muccc/flipdots/libsimplespi/README

1) run spi-setup as root
2) make install
3) reboot
4) PROFIT
