muccc/flipdots/board/FlipdotMini.brd

## EAGLE design board/FlipdotMini.brd (2017-11-04)

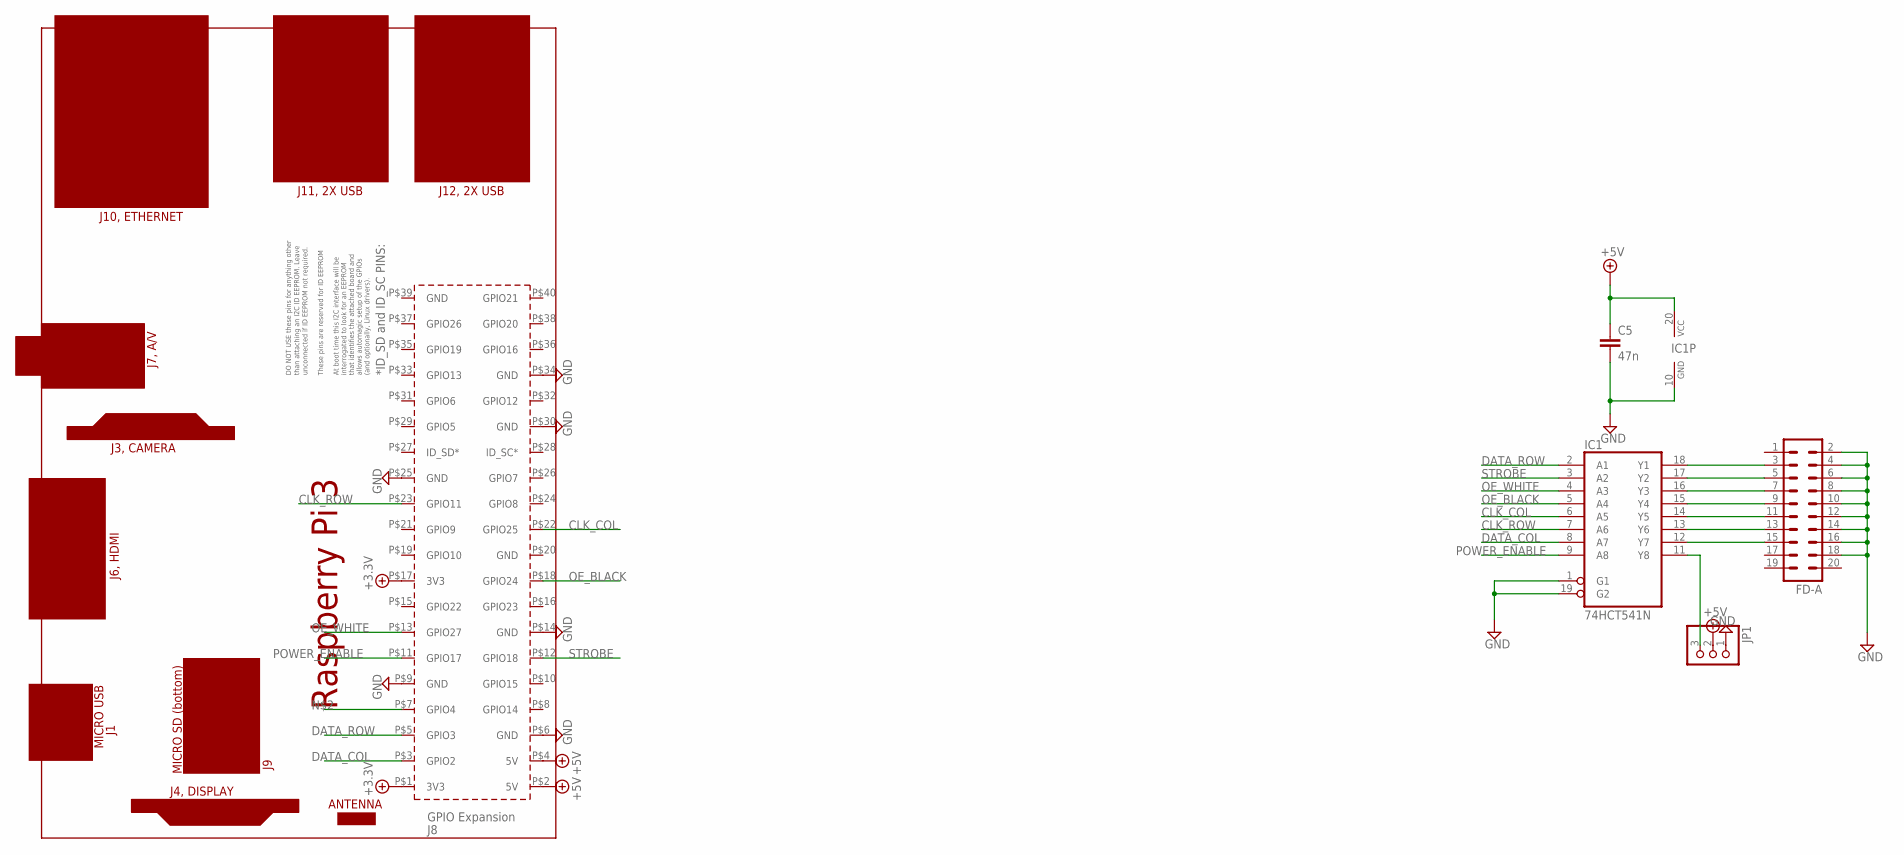
[picture p1: schematic FlipdotMini.sch]

Parts:
C5: 47n; C0805
FD-A: MA10-2
IC1: 74HCT541N; DIL20
JP1: PINHD-1X3; 1X03
PCB1: RPI3

Connections:
+3.3V: PCB1.P$1 (3V3), PCB1.P$17 (3V3)
+5V: C5.1, IC1.20 (VCC), JP1.2, PCB1.P$2 (5V), PCB1.P$4 (5V)
CLK_COL: IC1.6 (A5), PCB1.P$22 (GPIO25)
CLK_ROW: IC1.7 (A6), PCB1.P$23 (GPIO11)
DATA_COL: IC1.8 (A7), PCB1.P$3 (GPIO2)
DATA_ROW: IC1.2 (A1), PCB1.P$5 (GPIO3)
GND: C5.2, FD-A.2, FD-A.4, FD-A.6, FD-A.8, FD-A.10, FD-A.12, FD-A.14, FD-A.16, FD-A.18, IC1.1 (G1), IC1.10 (GND), IC1.19 (G2), JP1.1, PCB1.P$6 (GND), PCB1.P$9 (GND), PCB1.P$14 (GND), PCB1.P$25 (GND), PCB1.P$30 (GND), PCB1.P$34 (GND)
unnamed: FD-A.3, IC1.18 (Y1)
unnamed: FD-A.5, IC1.17 (Y2)
unnamed: FD-A.7, IC1.16 (Y3)
unnamed: FD-A.9, IC1.15 (Y4)
unnamed: FD-A.11, IC1.14 (Y5)
unnamed: FD-A.13, IC1.13 (Y6)
unnamed: FD-A.15, IC1.12 (Y7)
unnamed: IC1.11 (Y8), JP1.3
OE_BLACK: IC1.5 (A4), PCB1.P$18 (GPIO24)
OE_WHITE: IC1.4 (A3), PCB1.P$13 (GPIO27)
POWER_ENABLE: IC1.9 (A8), PCB1.P$11 (GPIO17)
STROBE: IC1.3 (A2), PCB1.P$12 (GPIO18)

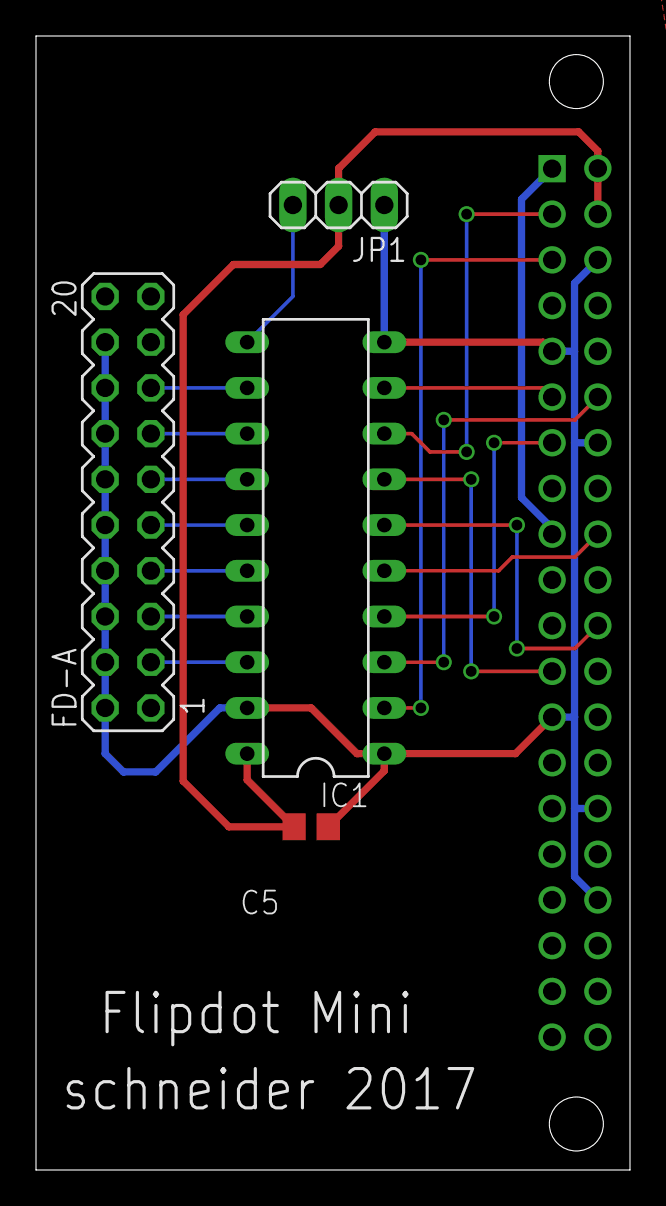
[picture p2: board FlipdotMini.brd from above]

Board: 2 copper layers, 33.0 x 63.0 mm, 5 parts (0 on the bottom side), 19 nets.
