muccc/flipdots/board/Flipdot.brd

## EAGLE design board/Flipdot.brd (2017-03-02)

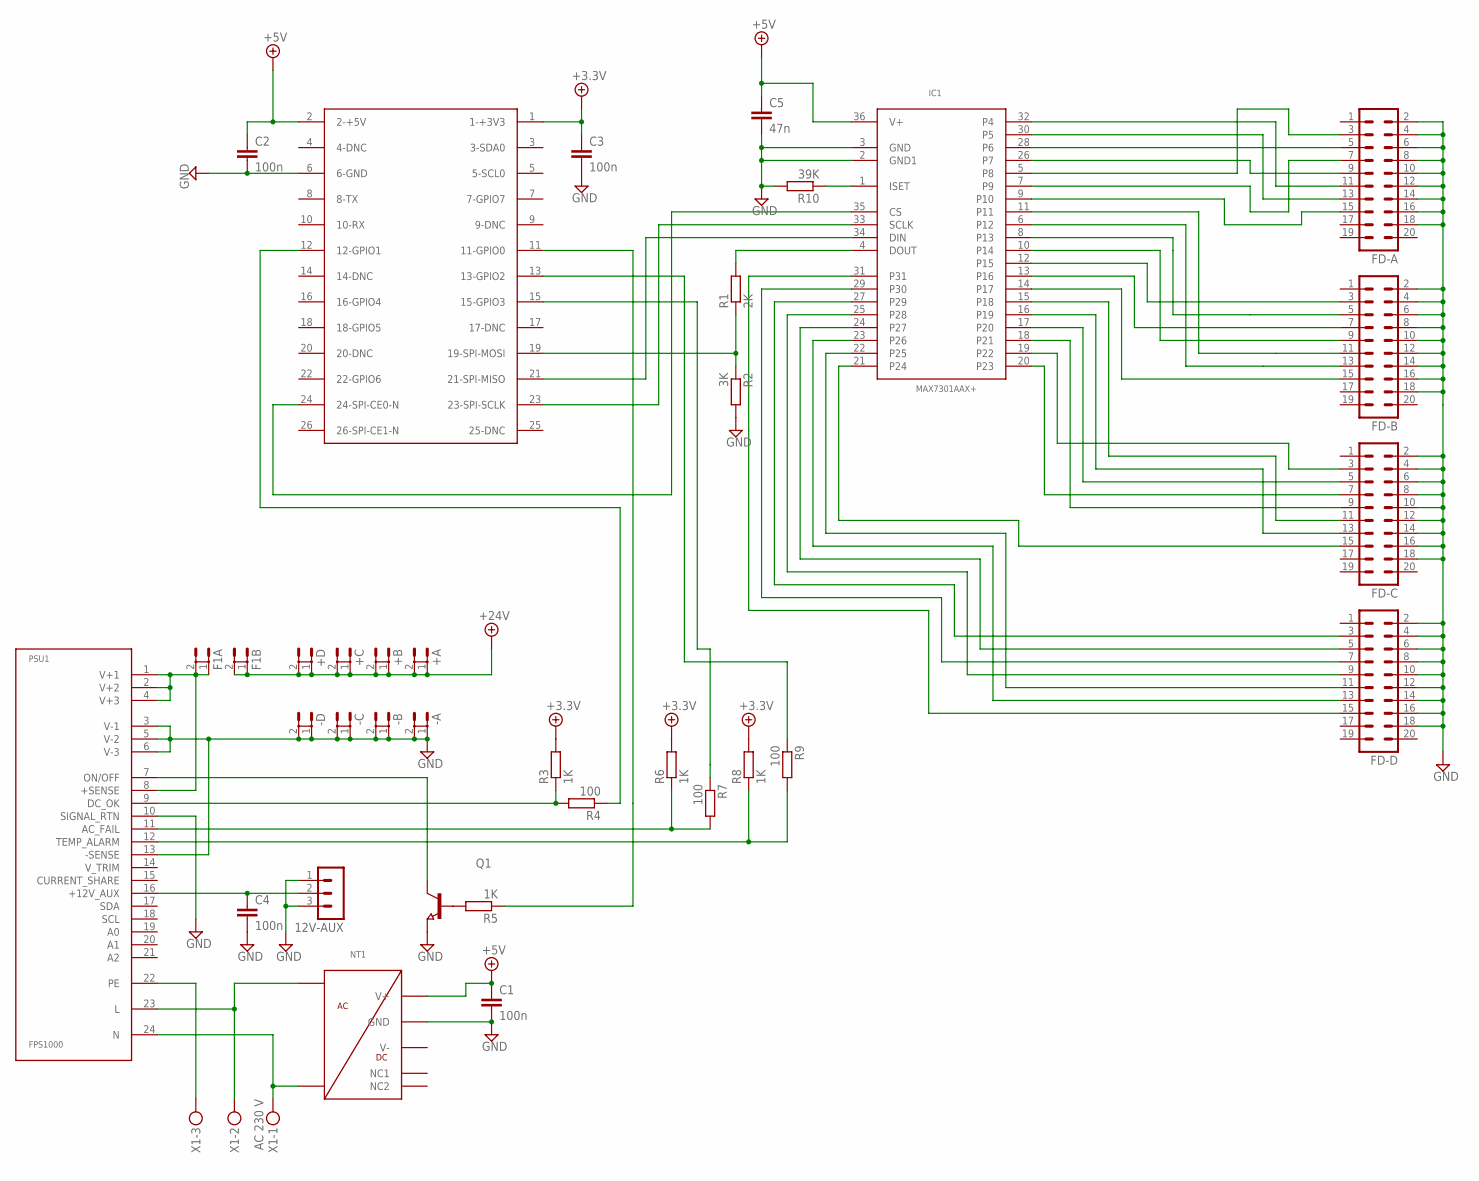
[picture p3: schematic Flipdot.sch]

Parts:
12V-AUX: MA03-1
+A: ST6,3
+B: ST6,3
+C: ST6,3
+D: ST6,3
-A: ST6,3
-B: ST6,3
-C: ST6,3
-D: ST6,3
C1, C2, C3, C4: 100n; C0603
C5: 47n; C0603
F1A, F1B: ST6,3
FD-A: MA10-2
FD-B: MA10-2
FD-C: MA10-2
FD-D: MA10-2
IC1: MAX7301AAX+; SSOP36
NT1: TMPM04; TPM04
PSU1: FPS1000; 24W9F
Q1: NPN-TRANSISTOR_SOT23; SOT23
R1: 2K; R0603
R2: 3K; R0603
R3, R5, R6, R8: 1K; R0603
R4, R7, R9: 100; R0603
R10: 39K; R0603
U$1: RASPBERRY-PI
X1: AC 230 V; MKDSN1,5/3-5,08

Connections:
+3.3V: C3.1, R3.2, R6.2, R8.2, U$1.1 (1-+3V3)
+5V: C1.1, C2.1, C5.1, IC1.36 (V+), NT1.3 (V+), U$1.2 (2-+5V)
+24V: +A.1, +A.2, +B.1, +B.2, +C.1, +C.2, +D.1, +D.2, F1B.1, F1B.2
GND: 12V-AUX.1, 12V-AUX.3, -A.1, -A.2, -B.1, -B.2, -C.1, -C.2, -D.1, -D.2, C1.2, C2.2, C3.2, C4.2, C5.2, FD-A.2, FD-A.4, FD-A.6, FD-A.8, FD-A.10, FD-A.12, FD-A.14, FD-A.16, FD-A.18, FD-B.2, FD-B.4, FD-B.6, FD-B.8, FD-B.10, FD-B.12, FD-B.14, FD-B.16, FD-B.18, FD-C.2, FD-C.4, FD-C.6, FD-C.8, FD-C.10, FD-C.12, FD-C.14, FD-C.16, FD-C.18, FD-D.2, FD-D.4, FD-D.6, FD-D.8, FD-D.10, FD-D.12, FD-D.14, FD-D.16, FD-D.18, IC1.2 (GND1), IC1.3 (GND), NT1.4 (GND), PSU1.3 (V-1), PSU1.5 (V-2), PSU1.6 (V-3), PSU1.10 (SIGNAL_RTN), PSU1.13 (-SENSE), Q1.2 (E), R2.2, R10.2, U$1.6 (6-GND)
unnamed: FD-D.11, IC1.22 (P25)
unnamed: FD-D.13, IC1.23 (P26)
unnamed: FD-A.5, IC1.28 (P6)
unnamed: FD-A.9, IC1.26 (P7)
unnamed: FD-A.3, IC1.5 (P8)
unnamed: FD-A.7, IC1.7 (P9)
unnamed: FD-A.15, IC1.9 (P10)
unnamed: FD-B.5, IC1.8 (P13)
unnamed: FD-B.9, IC1.10 (P14)
unnamed: FD-B.3, IC1.12 (P15)
unnamed: FD-B.7, IC1.13 (P16)
unnamed: FD-B.15, IC1.14 (P17)
unnamed: FD-C.5, IC1.17 (P20)
unnamed: FD-C.9, IC1.18 (P21)
unnamed: FD-C.3, IC1.19 (P22)
unnamed: FD-C.7, IC1.20 (P23)
unnamed: FD-C.15, IC1.21 (P24)
unnamed: FD-D.5, IC1.24 (P27)
unnamed: FD-D.9, IC1.25 (P28)
unnamed: FD-D.3, IC1.27 (P29)
unnamed: FD-D.7, IC1.29 (P30)
unnamed: FD-D.15, IC1.31
unnamed: IC1.33 (SCLK), U$1.23 (23-SPI-SCLK)
unnamed: IC1.35 (CS), U$1.24 (24-SPI-CE0-N)
unnamed: IC1.34 (DIN), U$1.21 (21-SPI-MISO)
unnamed: F1A.1, F1A.2, PSU1.1 (V+1), PSU1.2 (V+2), PSU1.4 (V+3), PSU1.8 (+SENSE)
unnamed: Q1.1 (B), R5.2
unnamed: PSU1.7 (ON/OFF), Q1.3 (C)
unnamed: PSU1.9 (DC_OK), R3.1, R4.2
unnamed: R5.1, U$1.11 (11-GPIO0)
unnamed: R4.1, U$1.12 (12-GPIO1)
unnamed: PSU1.11 (AC_FAIL), R6.1, R7.2
unnamed: R9.1, U$1.13 (13-GPIO2)
unnamed: PSU1.12 (TEMP_ALARM), R8.1, R9.2
unnamed: R7.1, U$1.15 (15-GPIO3)
unnamed: PSU1.22 (PE), X1.3
unnamed: FD-B.13, IC1.6 (P12)
unnamed: IC1.4 (DOUT), R1.2
unnamed: R1.1, R2.1, U$1.19 (19-SPI-MOSI)
unnamed: FD-B.11, IC1.11
unnamed: FD-C.11, IC1.15 (P18)
unnamed: FD-A.11, IC1.32 (P4)
unnamed: FD-C.13, IC1.16 (P19)
unnamed: FD-A.13, IC1.30 (P5)
unnamed: NT1.6 (N), PSU1.24 (N), X1.1
unnamed: NT1.7 (L), PSU1.23 (L), X1.2
unnamed: IC1.1 (ISET), R10.1
unnamed: 12V-AUX.2, C4.1, PSU1.16 (+12V_AUX)
NC1: NT1.1 (NC1)
NC2: NT1.2 (NC2)
V-: NT1.5 (V-)

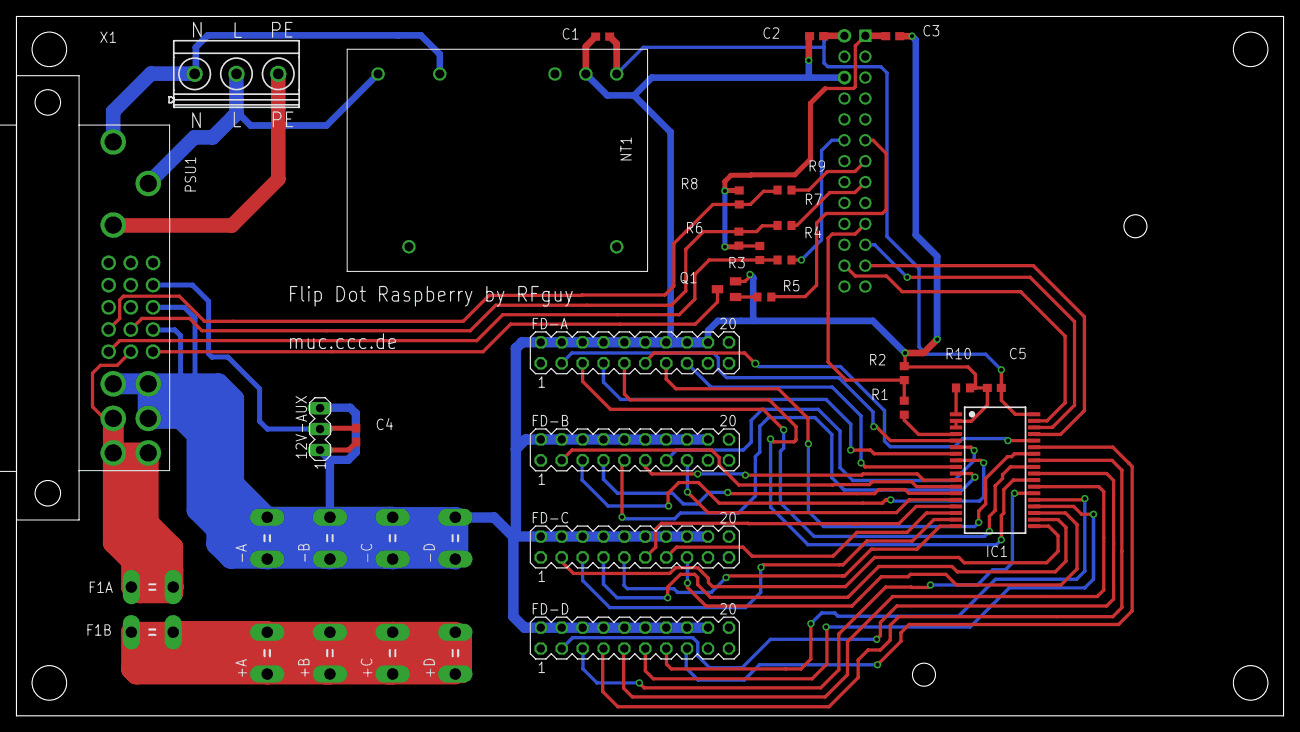
[picture p4: board Flipdot.brd from above]

Board: 2 copper layers, 154.0 x 85.0 mm, 36 parts (1 on the bottom side), 52 nets.
