muccc/flipdots/(threads)

Thread 7 (2013-09-22):

look for alternativ spi library or improve current one

schneider42, 2013-09-22:
the current one is slow and produces strange pulses on the /CS line.

Have a look a https://github.com/mstaflex/SPI-Py or quick to wire

dergigo, 2017-03-03:
@schneider42 are you still working on it?

schneider42, 2017-03-03:
We will replace the whole thing with direct GPIO access and remove the SPI port expander.

morawekj, 2017-03-03:
Neues PCB ?, ein Level Shifter wäre als Busentkopplung Sinnvoll

Closed 2017-03-03.

Thread 14 (2017-03-03):

Reimplement udp-receiver in C

dergigo, 2017-03-03:
The python file flipdots/rpi-demo/udp_receiver_and_translator.py runs on the zeile and the wand for the following reasons:
  * enable and disable 24V power as required
  * fix the strange orientation of the flipdots in the zeile.

Both should be features of the the udp-receiver.c

Thread 19 (2017-08-16):

Refactor python2 scripts for python3

markus2342, 2017-08-16:
There are a number of python2 scripts in the scripts directory which should be converted to python3.

Typical issues to be encountered will be the use of strings as arguments to socket.sendto. This behaviour has changed with python3. socket.sendto now accepts a byte type as argument.
Ideally these affected scripts would be modified to use the FlipdotAPI which takes care of sending data to the flipdot matrix.
