muccc/flipdots/rpi-demo/flipdot.c

/*
* Copyright (c) 2013 Franz Nord
*
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
* For more information on the GPL, please go to:
* http://www.gnu.org/copyleft/gpl.html
*/

#include "flipdot.h"
#include "config.h"

#include <bcm2835.h>
#include <time.h>
#include <stdlib.h>
#include <stdint.h>
#include <string.h>
#include <stdbool.h>
#include <unistd.h>
#include <inttypes.h>
#include <stdio.h>


#if INVERT_GPIO
#define OH LOW
#define OL HIGH
#else
#define OH HIGH
#define OL LOW
#endif

//extern int usleep (__useconds_t __useconds);
//#define _delay_us(x) usleep(x)
#define _delay_us(x) bcm2835_delayMicroseconds(x)


#define ISBITSET(x,i) ((x[i>>3] & (1<<(i&7)))!=0)
#define SETBIT(x,i) x[i>>3]|=(1<<(i&7));

#define DATA(reg)                                \
    ((reg == ROW) ? pinning.data_row : pinning.data_col)
#define CLK(reg)                                \
    ((reg == ROW) ? pinning.clk_row : pinning.clk_col)

static uint8_t buffer_a[DISP_BYTE_COUNT];
static uint8_t buffer_b[DISP_BYTE_COUNT];
static uint8_t buffer_to_0[DISP_BYTE_COUNT];
static uint8_t buffer_to_1[DISP_BYTE_COUNT];
static uint8_t *buffer_new, *buffer_old;

static void sreg_push_bit(enum sreg reg, uint8_t bit);
static void sreg_fill(enum sreg reg, uint8_t *data, int count);
static void sreg_fill_row(uint8_t *data, int count);
static void sreg_fill_col(uint8_t *data, int count);

static void strobe(void);
static void flip_white_start(void);
static void flip_white_stop(void);
static void flip_black_start(void);
static void flip_black_stop(void);

uint8_t diff_to_0(uint8_t old, uint8_t new);
uint8_t diff_to_1(uint8_t old, uint8_t new);

static void map_two_buffers(uint8_t (*fun)(uint8_t, uint8_t), uint8_t a[], uint8_t b[], uint8_t dst[], unsigned int count);

static void display_frame_differential(uint8_t *to_0, uint8_t *to_1);

#define PIN_POWER_ENABLE    RPI_V2_GPIO_P1_11
// XXX: Change to symbolic defines like RPI_V2_GPIO_P1_03
flipdot_pinning pinning =
{
    .data_col = RPI_V2_GPIO_P1_03, .data_row = RPI_V2_GPIO_P1_05, .strobe = RPI_V2_GPIO_P1_12, .oe_white = RPI_V2_GPIO_P1_13, .oe_black = RPI_V2_GPIO_P1_18, .clk_col = RPI_V2_GPIO_P1_22, .clk_row = RPI_V2_GPIO_P1_23
};

static uint8_t flipper[256];

static uint8_t reverse(uint8_t b)
{
    b = (b & 0xF0) >> 4 | (b & 0x0F) << 4;
    b = (b & 0xCC) >> 2 | (b & 0x33) << 2;
    b = (b & 0xAA) >> 1 | (b & 0x55) << 1;
    return b;
}

int
flipdot_init(void)
{
    //bcm2835_set_debug(1);
    if (!bcm2835_init())
        return 1;

    /* init pins */
    bcm2835_gpio_fsel(PIN_POWER_ENABLE, BCM2835_GPIO_FSEL_OUTP);

    bcm2835_gpio_fsel(pinning.data_col, BCM2835_GPIO_FSEL_OUTP);
    bcm2835_gpio_fsel(pinning.data_row, BCM2835_GPIO_FSEL_OUTP);
    bcm2835_gpio_fsel(pinning.strobe, BCM2835_GPIO_FSEL_OUTP);
    bcm2835_gpio_fsel(pinning.oe_white, BCM2835_GPIO_FSEL_OUTP);
    bcm2835_gpio_fsel(pinning.oe_black, BCM2835_GPIO_FSEL_OUTP);
    bcm2835_gpio_fsel(pinning.clk_col, BCM2835_GPIO_FSEL_OUTP);
    bcm2835_gpio_fsel(pinning.clk_row, BCM2835_GPIO_FSEL_OUTP);

    /* Init buffer pointers */
    buffer_new = buffer_a;
    buffer_old = buffer_b;

    /* Synchronize buffers and flipdot pixel state */
    memset(buffer_new, 0xFF, DISP_BYTE_COUNT);
    memset(buffer_old, 0x00, DISP_BYTE_COUNT);

    flipdot_power_on();
    flipdot_data(buffer_old, DISP_BYTE_COUNT);
    flipdot_data(buffer_old, DISP_BYTE_COUNT);
    flipdot_data(buffer_old, DISP_BYTE_COUNT);
    flipdot_power_off();

    int i;
    for(i=0; i<256; i++) {
        flipper[i] = reverse(i);
    }
    
    return 0;
}

void
flipdot_power_on(void)
{
    bcm2835_gpio_write(PIN_POWER_ENABLE, OH);
    while(bcm2835_gpio_lev(PIN_POWER_ENABLE) == OL){
        printf("Power set error\n");
        bcm2835_gpio_write(PIN_POWER_ENABLE, OH);
    }
}

void
flipdot_power_off(void)
{
    bcm2835_gpio_write(PIN_POWER_ENABLE, OL);
    while(bcm2835_gpio_lev(PIN_POWER_ENABLE) == OH){
        printf("Power clear error\n");
        bcm2835_gpio_write(PIN_POWER_ENABLE, OL);
    }
}

void
flipdot_data(uint8_t *frame, uint16_t size)
{
    uint8_t *tmp;

    memcpy(buffer_old, frame, size); /* Copy frame into buffer with old data */
    
    int i;
    for(i = 0; i < size; i++) {
        uint8_t c = buffer_old[i];
        buffer_old[i] = flipper[c];
    }

    tmp = buffer_old;                 /* swap pointers buffer_new and buffer_old */
    buffer_old = buffer_new;
    buffer_new = tmp;
    
    map_two_buffers(diff_to_0, buffer_old, buffer_new, buffer_to_0, DISP_BYTE_COUNT);
    map_two_buffers(diff_to_1, buffer_old, buffer_new, buffer_to_1, DISP_BYTE_COUNT);

    display_frame_differential(buffer_to_0, buffer_to_1);
}

static void
map_two_buffers(uint8_t (*fun)(uint8_t, uint8_t), uint8_t a[], uint8_t b[], uint8_t dst[], unsigned int count) {
    for (int i = 0; i < count; ++i) {
        dst[i] = fun(a[i], b[i]);
    }
}

uint8_t
diff_to_0(uint8_t old, uint8_t new) {
    return old & ~new;
}

uint8_t
diff_to_1(uint8_t old, uint8_t new) {
    return ~(~old & new);
}


static uint64_t timer;

static uint64_t
get_time(void)
{
    struct timespec time;
    clock_gettime(CLOCK_MONOTONIC_RAW, &time);
    uint64_t time_us = time.tv_sec * 1000000 + time.tv_nsec / 1000;
    return time_us;
}

static void
timer_start(void)
{
    timer = get_time();
}

static void
timer_wait(uint32_t micros)
{
    if(micros == 0) {
        return;
    }

    uint64_t elapsed = get_time() - timer;
    if(micros > elapsed) {
        _delay_us(micros - elapsed);
    } else {
        printf("Too slow: %" PRIu64 "/%" PRIu32 "\n", elapsed, micros);
    }
}

#if 1
// Load new row data while flipping
static void
display_frame_differential(uint8_t *to_0, uint8_t *to_1)
{
    uint8_t row_select[DISP_ROWS/8];
    int row;
    uint8_t *row_data_to_0, *row_data_to_1;

    // Select the first row
    row = 0;    
    memset(row_select, 0, DISP_ROWS/8);
    SETBIT(row_select, row);               /* Set selected row */
    sreg_fill(COL, row_select, DISP_ROWS); /* Fill row select shift register */

    // Pre-fill the data for row 0
    row_data_to_0 = to_0 + row * DISP_COLS/8;
    sreg_fill(ROW, row_data_to_0, DISP_COLS); /* Fill row to 0 shift register */

    while(row < DISP_ROWS) {
        // Apply the shift register content for the black pixels
        strobe();
        flip_black_start();

        row_data_to_1 = to_1 + row * DISP_COLS/8;
        sreg_fill(ROW, row_data_to_1, DISP_COLS); /* Fill row to 1 shift register */

        flip_black_stop();
        // Apply the shift register content for the white pixels
        strobe();
        flip_white_start();

        // Move one row further
        sreg_push_bit(COL, 0);
        row_data_to_0 = to_0 + (row+1) * DISP_COLS/8;
        sreg_fill(ROW, row_data_to_0, DISP_COLS); /* Fill row to 0 shift register */

        flip_white_stop();
        row++;
    }
}
#else
// Load new row data between flipping (slower)
static void
display_frame_differential(uint8_t *to_0, uint8_t *to_1)
{
    uint8_t row_select[DISP_ROWS/8];

    for (int row = 0; row < DISP_ROWS; ++row) {
        uint8_t *row_data_to_0 = to_0 + row * DISP_COLS/8;
        uint8_t *row_data_to_1 = to_1 + row * DISP_COLS/8;
        
        memset(row_select, 0, DISP_ROWS/8);
        SETBIT(row_select, row);               /* Set selected row */
        sreg_fill(COL, row_select, DISP_ROWS); /* Fill row select shift register */
        
        sreg_fill(ROW, row_data_to_0, DISP_COLS); /* Fill row to 0 shift register */
        strobe();
        flip_black_start();
        flip_black_stop();

        sreg_fill(ROW, row_data_to_1, DISP_COLS); /* Fill row to 1 shift register */
        strobe();
        flip_white_start();
        flip_white_stop();
    }
}
#endif

/* Output bit on reg and pulse clk signal */
static void
sreg_push_bit(enum sreg reg, uint8_t bit)
{
#ifdef CLK_DELAY
    volatile int i;
#endif
    uint8_t out;
    if(bit) {
        out = OH;
    } else {
        out = OL;
    }

    bcm2835_gpio_write(DATA(reg), out);
    while(bcm2835_gpio_lev(DATA(reg)) != out){
        printf("Data error\n");
        bcm2835_gpio_write(DATA(reg), out);
    }
#ifdef CLK_DELAY
    for(i=0; i<CLK_DELAY; i++);
#endif
    bcm2835_gpio_write(CLK(reg), OH);
    while(bcm2835_gpio_lev(CLK(reg)) == OL){
        printf("Clock set error\n");
        bcm2835_gpio_write(CLK(reg), OH);
    }
#ifdef CLK_DELAY
    for(i=0; i<CLK_DELAY; i++);
#endif
    bcm2835_gpio_write(CLK(reg), OL);
    while(bcm2835_gpio_lev(CLK(reg)) == OH){
        printf("Clock clear error\n");
        bcm2835_gpio_write(CLK(reg), OL);
    }
}

static void
sreg_fill(enum sreg reg, uint8_t *data, int count)
{
    switch (reg) {
        case ROW: sreg_fill_row(data, count); break;
        case COL: sreg_fill_col(data, count); break;
    }
}

/* Fill col register with count bits from data LSB first */
static void
sreg_fill_col(uint8_t *data, int count)
{
    int i = 0;
    while (i < count) {
        sreg_push_bit(COL, ISBITSET(data, (count-i-1)));
        ++i;
    }
}

/* TODO: generalize for more panels */
static void
sreg_fill_row(uint8_t *data, int count)
{
    /* This is necessary because the row
    * register has 4 unmapped bits */
    int i;
    int bit = 0;

    // Send 4 extra bits at the beginnig
    int c = 20;

    for(i = 0; i < count; i++) {
        if(c == 20) {
            // 20 bits have been pushed, send the 4
            // extra bits now.
            sreg_push_bit(ROW, bit);
            sreg_push_bit(ROW, bit);
            sreg_push_bit(ROW, bit);
            sreg_push_bit(ROW, bit);
            c = 0;
        }
        bit = ISBITSET(data, (count-i-1)) ? 1 : 0;
        /* count-i-1 because the first bit needs to go last */
        sreg_push_bit(ROW, bit);
        c++;
    }    
}

static void
strobe(void)
{
    bcm2835_gpio_write(pinning.strobe, OH);
    while(bcm2835_gpio_lev(pinning.strobe) == OL){
        printf("Strobe set error\n");
        bcm2835_gpio_write(pinning.strobe, OH);
    }
    _delay_us(STROBE_DELAY);
    bcm2835_gpio_write(pinning.strobe, OL);
    while(bcm2835_gpio_lev(pinning.strobe) == OH){
        printf("Strobe clear error\n");
        bcm2835_gpio_write(pinning.strobe, OL);
    }
}

static void
flip_white_start(void)
{
    timer_start();
    bcm2835_gpio_write(pinning.oe_black, OL);
    while(bcm2835_gpio_lev(pinning.oe_black) == OH){
        printf("OE black clear error\n");
        bcm2835_gpio_write(pinning.oe_black, OL);
    }
    bcm2835_gpio_write(pinning.oe_white, OH);
    while(bcm2835_gpio_lev(pinning.oe_white) == OL){
        printf("OE white set error\n");
        bcm2835_gpio_write(pinning.oe_white, OH);
    }
}

static void
flip_white_stop(void)
{
    timer_wait(FLIP_DELAY_WHITE);
    bcm2835_gpio_write(pinning.oe_black, OL);
    while(bcm2835_gpio_lev(pinning.oe_black) == OH){
        printf("OE black clear error\n");
        bcm2835_gpio_write(pinning.oe_black, OL);
    }
    bcm2835_gpio_write(pinning.oe_white, OL);
    while(bcm2835_gpio_lev(pinning.oe_white) == OH){
        printf("OE white clear error\n");
        bcm2835_gpio_write(pinning.oe_white, OL);
    }
}

static void
flip_black_start(void)
{
    timer_start();
    bcm2835_gpio_write(pinning.oe_black, OH);
    while(bcm2835_gpio_lev(pinning.oe_black) == OL){
        printf("OE black set error\n");
        bcm2835_gpio_write(pinning.oe_black, OH);
    }
    bcm2835_gpio_write(pinning.oe_white, OL);
    while(bcm2835_gpio_lev(pinning.oe_white) == OH){
        printf("OE white clear error\n");
        bcm2835_gpio_write(pinning.oe_white, OL);
    }
}

static void
flip_black_stop(void)
{
    timer_wait(FLIP_DELAY_BLACK);
    bcm2835_gpio_write(pinning.oe_black, OL);
    while(bcm2835_gpio_lev(pinning.oe_black) == OH){
        printf("OE black clear error\n");
        bcm2835_gpio_write(pinning.oe_black, OL);
    }
    bcm2835_gpio_write(pinning.oe_white, OL);
    while(bcm2835_gpio_lev(pinning.oe_white) == OH){
        printf("OE white clear error\n");
        bcm2835_gpio_write(pinning.oe_white, OL);
    }
}
