muccc/flipdots/rpi-demo/translate.c

#include "translate.h"
#include "config.h"
#include <string.h>
#include <stdint.h>

static int get_bit(uint8_t *data, int bit)
{
    return data[bit/8] & 1 << (7- (bit % 8));
}

static void set_bit(uint8_t *data, int bit)
{
    data[bit/8] |= 1 << (7- (bit % 8));
}

void translate(uint8_t *in, uint8_t *out, int n)
{
    memset(out, 0, n);
    for(int i = 0; i < n * 8; i++) {
        if(get_bit(in, i)) {
            int xL = i % XL;
            int yL = i / XL;

            int colP = xL % 16;
 #if LEFT_TO_RIGHT
            int rowP = xL / 16 * YL - yL - 1;
 #else
            int rowP = (XL / 16 - (xL / 16)) * YL - yL - 1;
 #endif

            int bit = colP * YP + rowP;
            set_bit(out, bit);
        }
    }
}
