muccc/flipdots/(commit log)

2013-06-16 Added #includes that include xbm files which will be played back at high framerate
2013-06-23 Updated to new embedded flipdot driver with differential display
2013-06-23 Added a noise.py script that shows white noise with a sine modulated power
2013-09-16 Adding Board
    [Flipdot.brd, Flipdot.sch]
2013-09-24 feat(rpi-demo): add scripts to control the 24 V supply
2013-09-26 fix(rpi-demo): use correct module count and account for row gap
    [flipdot.c, flipdot.h]
2013-09-26 fix(rpi-demo): fix output of power_on script
2013-09-26 feat(rpi-demo): flipdot udp receiver
    [flipdot_net.c, flipdot_net.h, udp-receiver.c]
2013-09-27 fix(board): move gpio from pin 17 to pin 3
    [Flipdot.brd, Flipdot.sch]
2013-09-29 fix(rpidemo): move to IPv6
    [flipdot_net.c]
2013-10-27 fix(udp-receiver): do not clear the displya right after booting
    [udp-receiver.c]
2013-11-04 support for all 3 assemblies
2017-03-01 change(flipdot): Fill registers while flipping
    [flipdot.c, flipdot.h]
2017-03-02 feat(board): outline for a touch protection for the live parts.
    [Flipdot.brd]
2017-03-03 FlipdotApi: store current ip/port config in separate file
2017-03-03 FlipdotAPI: switch to python3
2017-03-06 fix(rpi-demo): Current timings and pins
    [flipdot.c, flipdot.h]
2017-03-06 fix(flipdot): Read GPIOs back to verify the change
    [config.h, flipdot.c, flipdot.h]
2017-03-06 feat(flipdot): Print warnings when the GPIO write failed
    [flipdot.c]
2017-03-06 chore(flipdot): Change tabs to spaces
    [flipdot.c, flipdot.h, flipdot_net.h]
2017-03-06 feat(udp-receiver): Pixel translator for flipdotwand
    [config.h, translate.c, udp-receiver.c]
2017-03-06 feat(udp-receiver): Basic power control
2017-08-16 pong: Print warning when fps are too high for the system
2017-08-16 tron: use python3 and adjust to current API
2017-08-17 add ipv4 support for input handler socket
2017-11-04 feat(board): FlipdotMini board
    [FlipdotMini.brd, FlipdotMini.sch]
2018-06-04 feat(rpi-demo): Option to invert the outputs
    [config.h, flipdot.c]
2018-06-05 change(rpi-demo): INVERT -> INVERT_GPIO
    [config.h, flipdot.c]
