muccc/flipdots/(notices)

Notices in the files:
rpi-demo/flipdot.c:
modify it under the terms of the GNU General Public License
